welbertdeoliveira/Protecao-contra-descargas-atmosfericas/DIAGRAMAS - IMAGENS E FOTOS/2013-05-27_16-30-04_356 (1).jpg

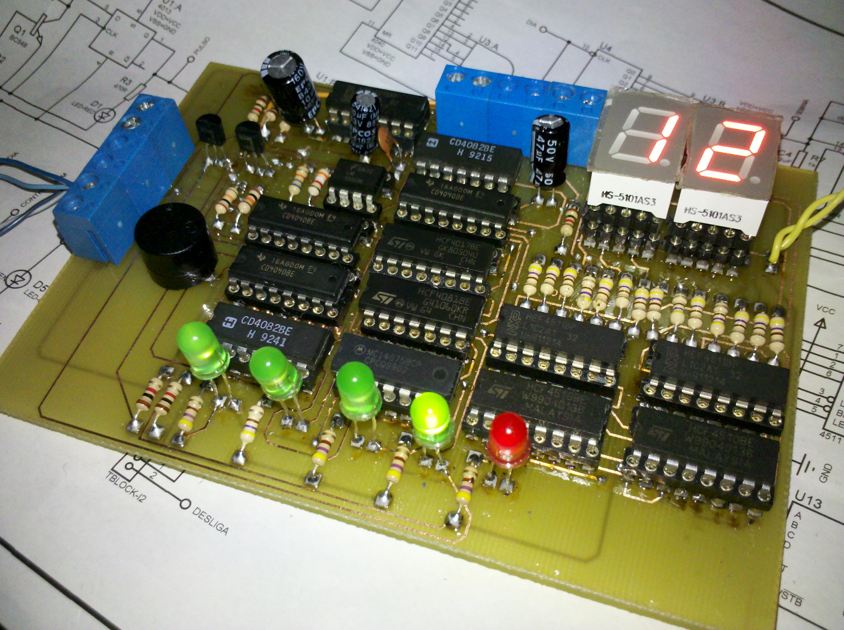
DIAGRAMAS - IMAGENS E FOTOS/2013-05-27_16-30-04_356 (1).jpg
