welbertdeoliveira/Protecao-contra-descargas-atmosfericas/BANNER/BANNER.pdf

# PROTEÇÃO ELETRÔNICA CONTRA SURTOS NA REDE ELÉTRICA

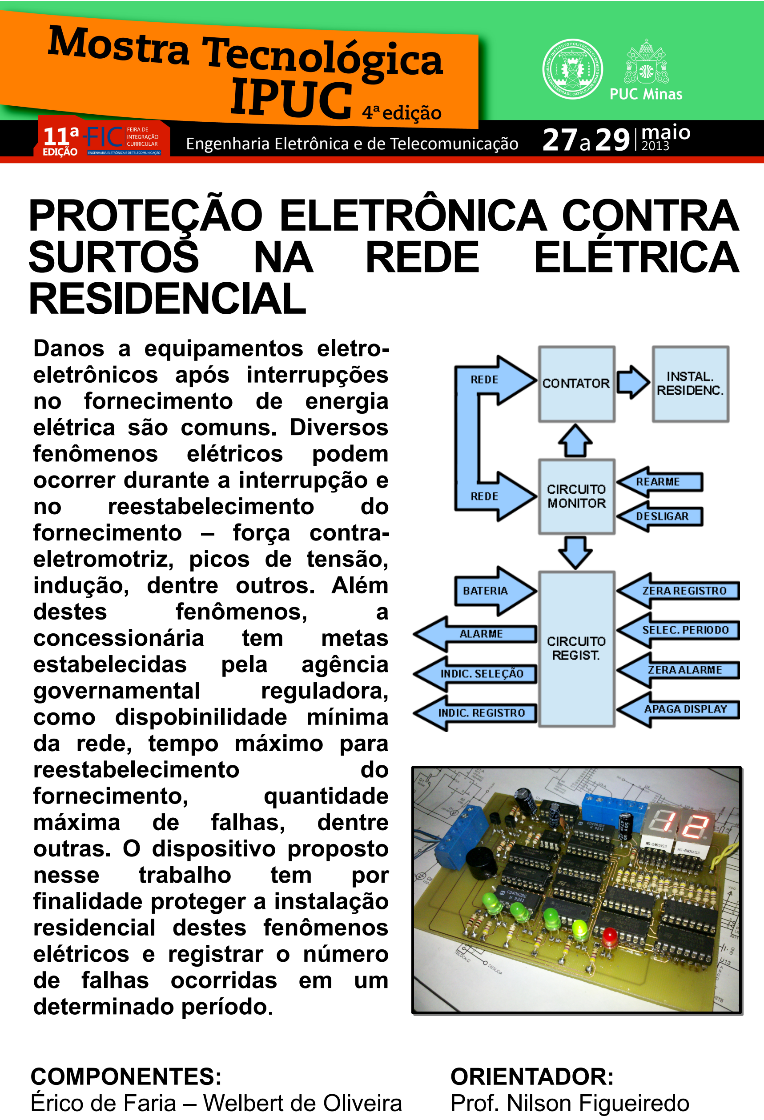
[picture p6: page 1]

Danos a equipamentos eletroeletrônicos após interrupções no fornecimento de energia elétrica são comuns. Diversos fenômenos elétricos podem
ocorrer durante a interrupção e
no | reestabelecimento | do
fornecimento – força contraeletromotriz, picos de tensão, indução, dentre outros. Além
destes | fenômenos, | a
concessionária | tem | metas
estabelecidas | pela | agência
governamental | reguladora,
como dispobinilidade mínima da rede, tempo máximo para
reestabelecimento | do
fornecimento, | quantidade
máxima de falhas, dentre
outras. O dispositivo proposto
nesse | trabalho | tem | por
finalidade proteger a instalação residencial destes fenômenos elétricos e registrar o número de falhas ocorridas em um
determinado período.

# RESIDENCIAL

COMPONENTES:
Érico de Faria – Welbert de Oliveira

ORIENTADOR:
Prof. Nilson Figueiredo

Engenharia Eletrônica e de Telecomunicação
