welbertdeoliveira/Protecao-contra-descargas-atmosfericas/DIAGRAMAS - IMAGENS E FOTOS/CIRCUITO MONITOR.BMP

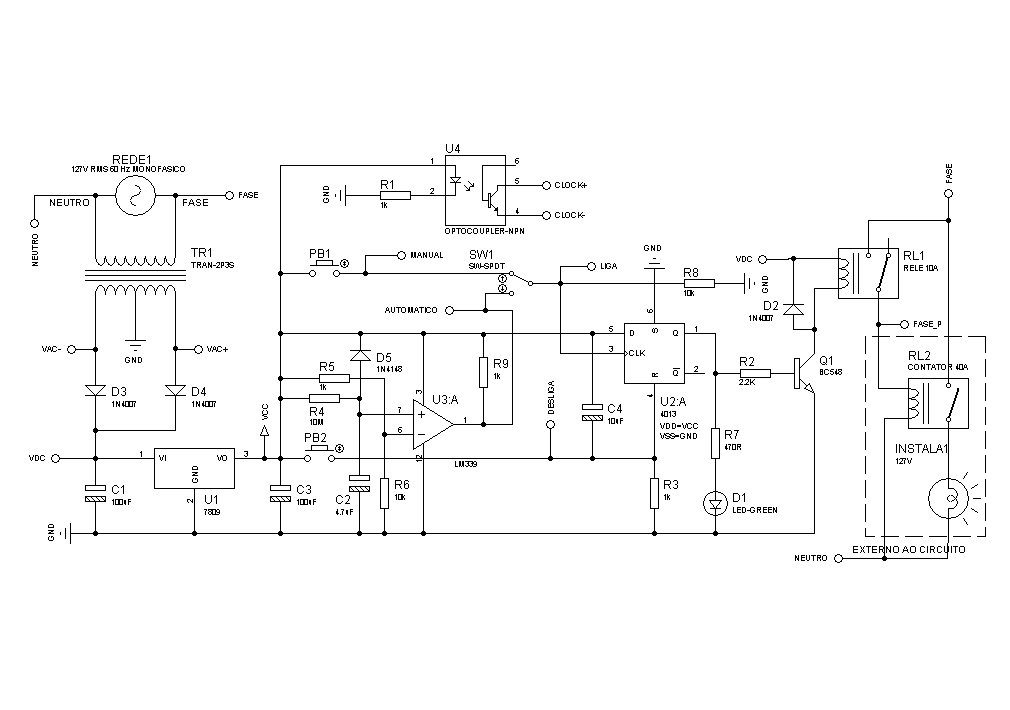
DIAGRAMAS - IMAGENS E FOTOS/CIRCUITO MONITOR.BMP
