welbertdeoliveira/Protecao-contra-descargas-atmosfericas/DIAGRAMAS - IMAGENS E FOTOS/circuito registrador - parte 2.bmp

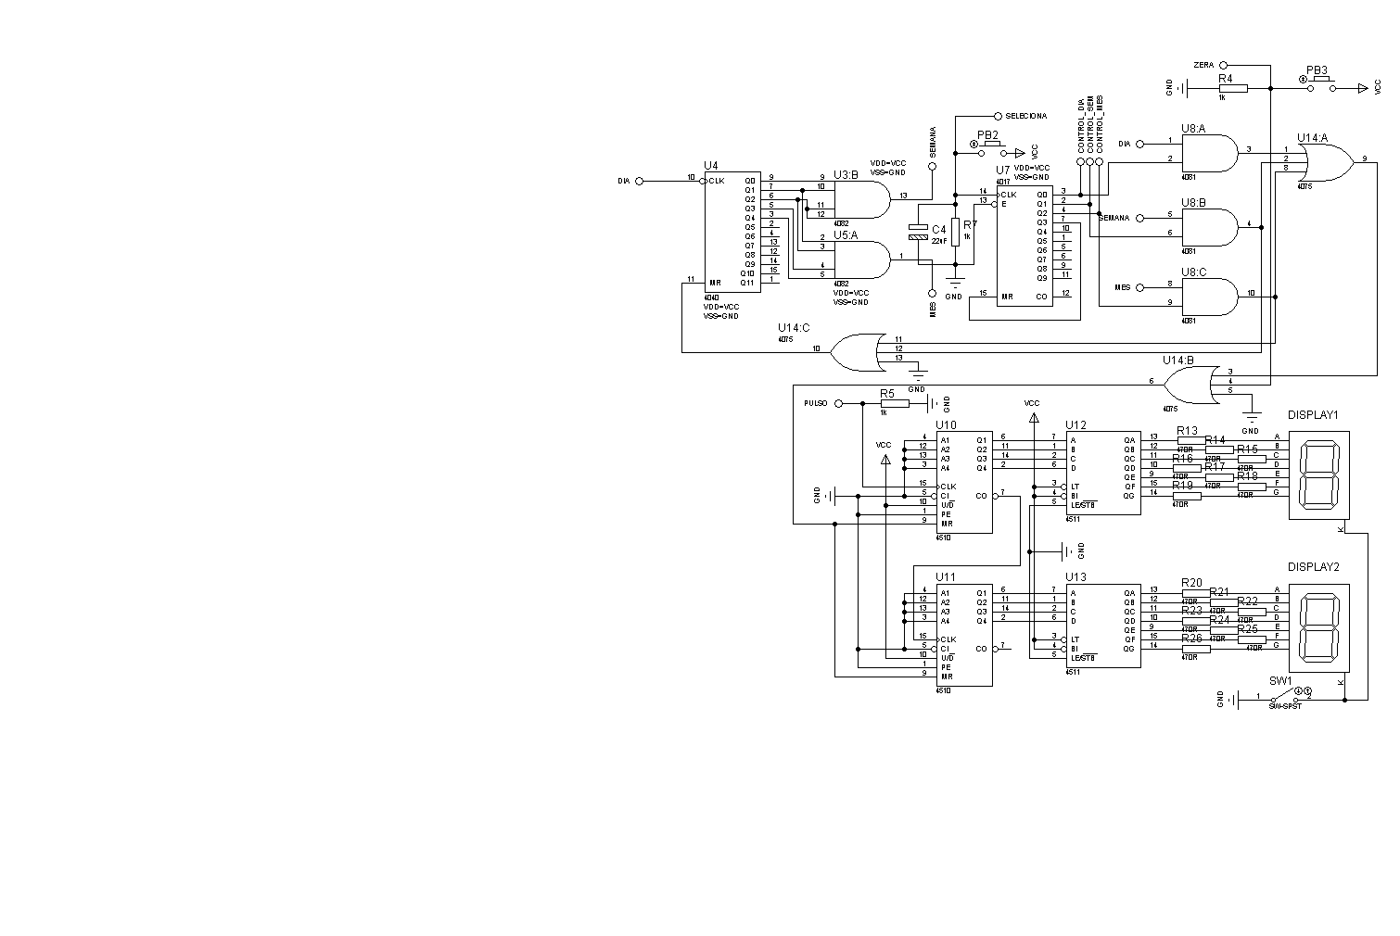
DIAGRAMAS - IMAGENS E FOTOS/circuito registrador - parte 2.bmp
