welbertdeoliveira/Protecao-contra-descargas-atmosfericas/DIAGRAMAS - IMAGENS E FOTOS/CIRCUITO REGISTRADOR.BMP

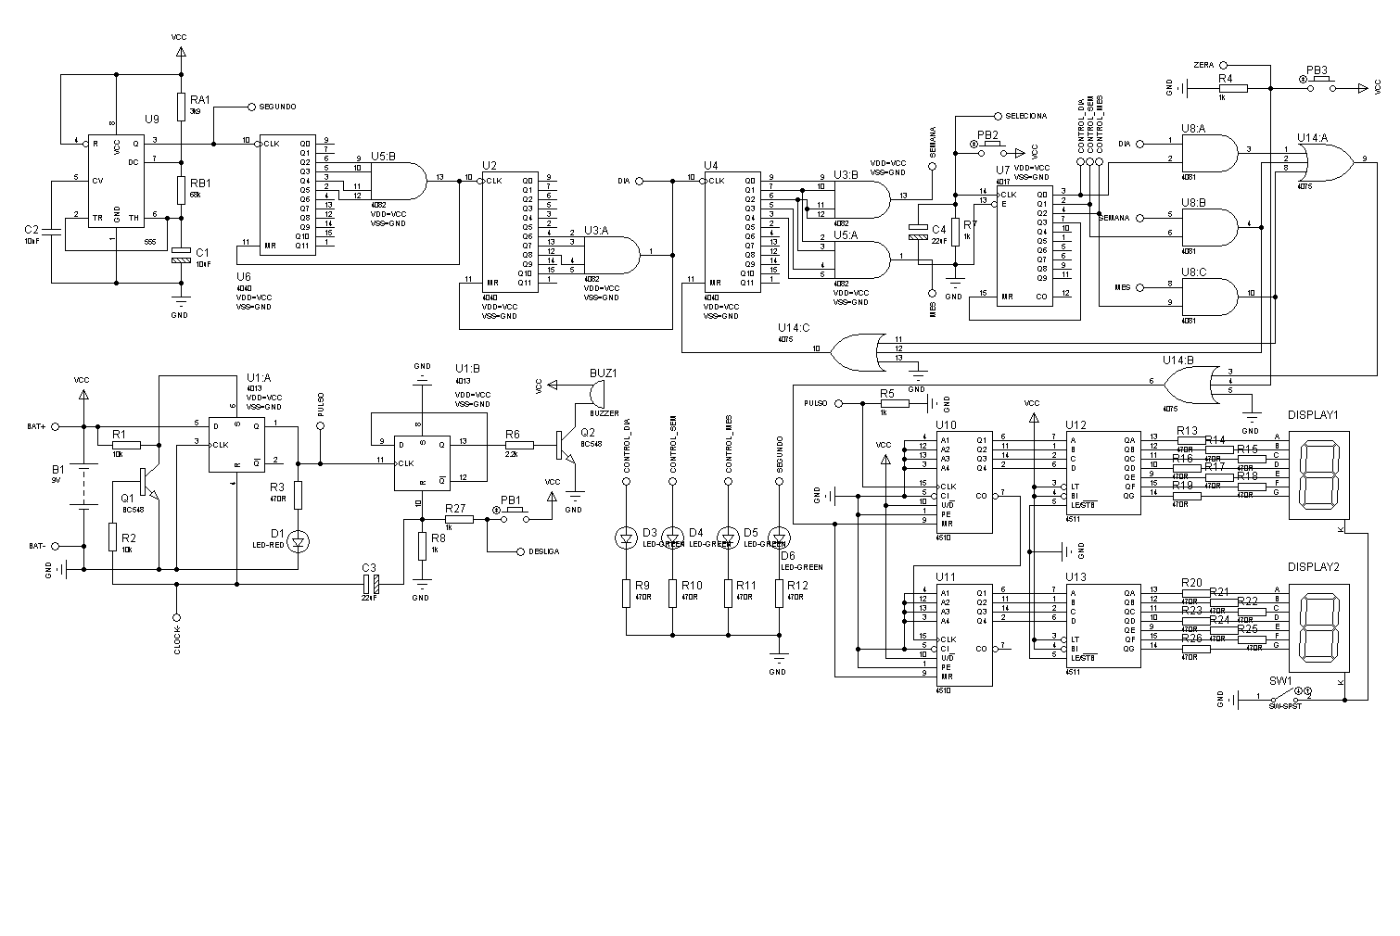
DIAGRAMAS - IMAGENS E FOTOS/CIRCUITO REGISTRADOR.BMP
