welbertdeoliveira/Protecao-contra-descargas-atmosfericas/DIAGRAMAS - IMAGENS E FOTOS/registrador_bmp.bmp

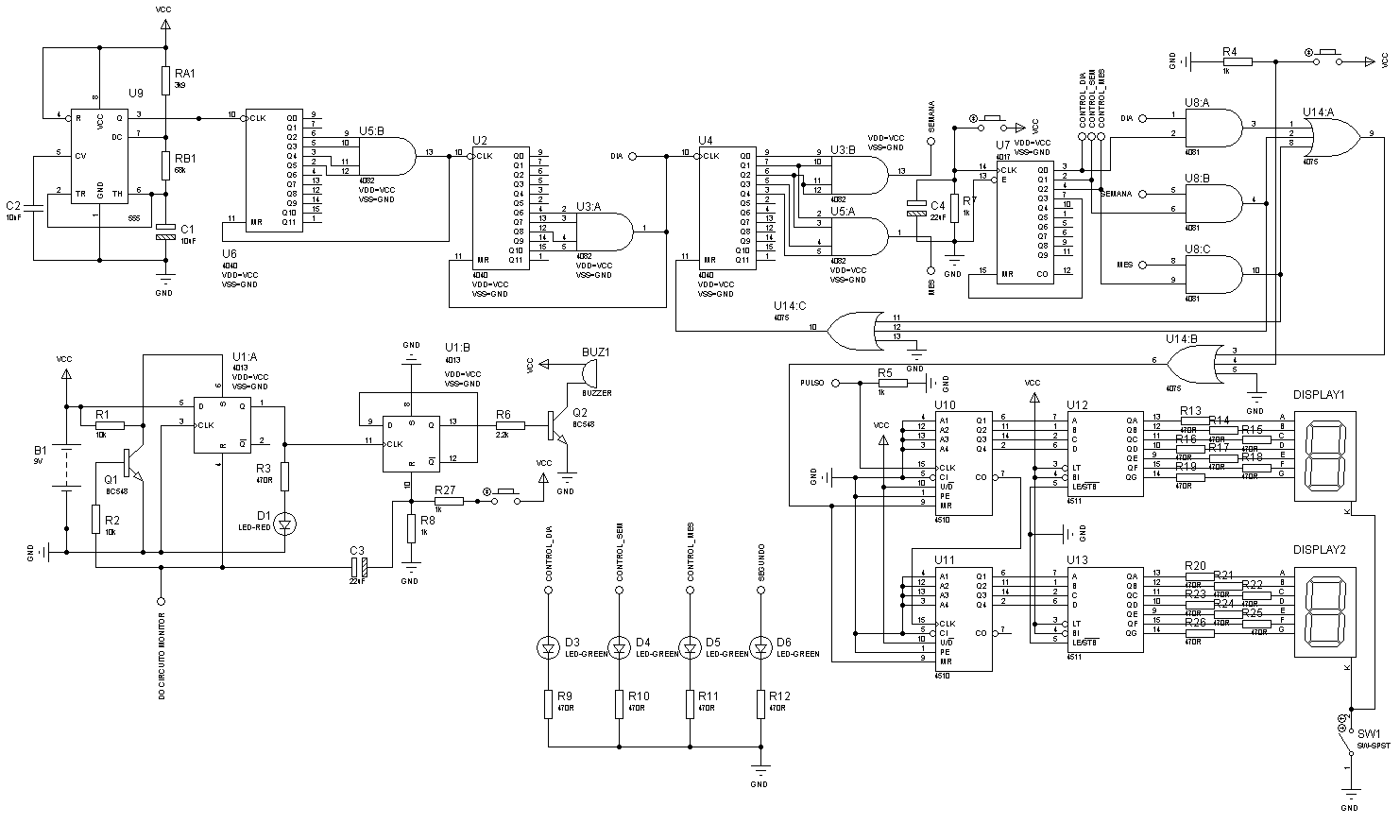
DIAGRAMAS - IMAGENS E FOTOS/registrador_bmp.bmp
