welbertdeoliveira/Protecao-contra-descargas-atmosfericas/DIAGRAMAS - IMAGENS E FOTOS/PROJETO 2.pdf

J1

J2

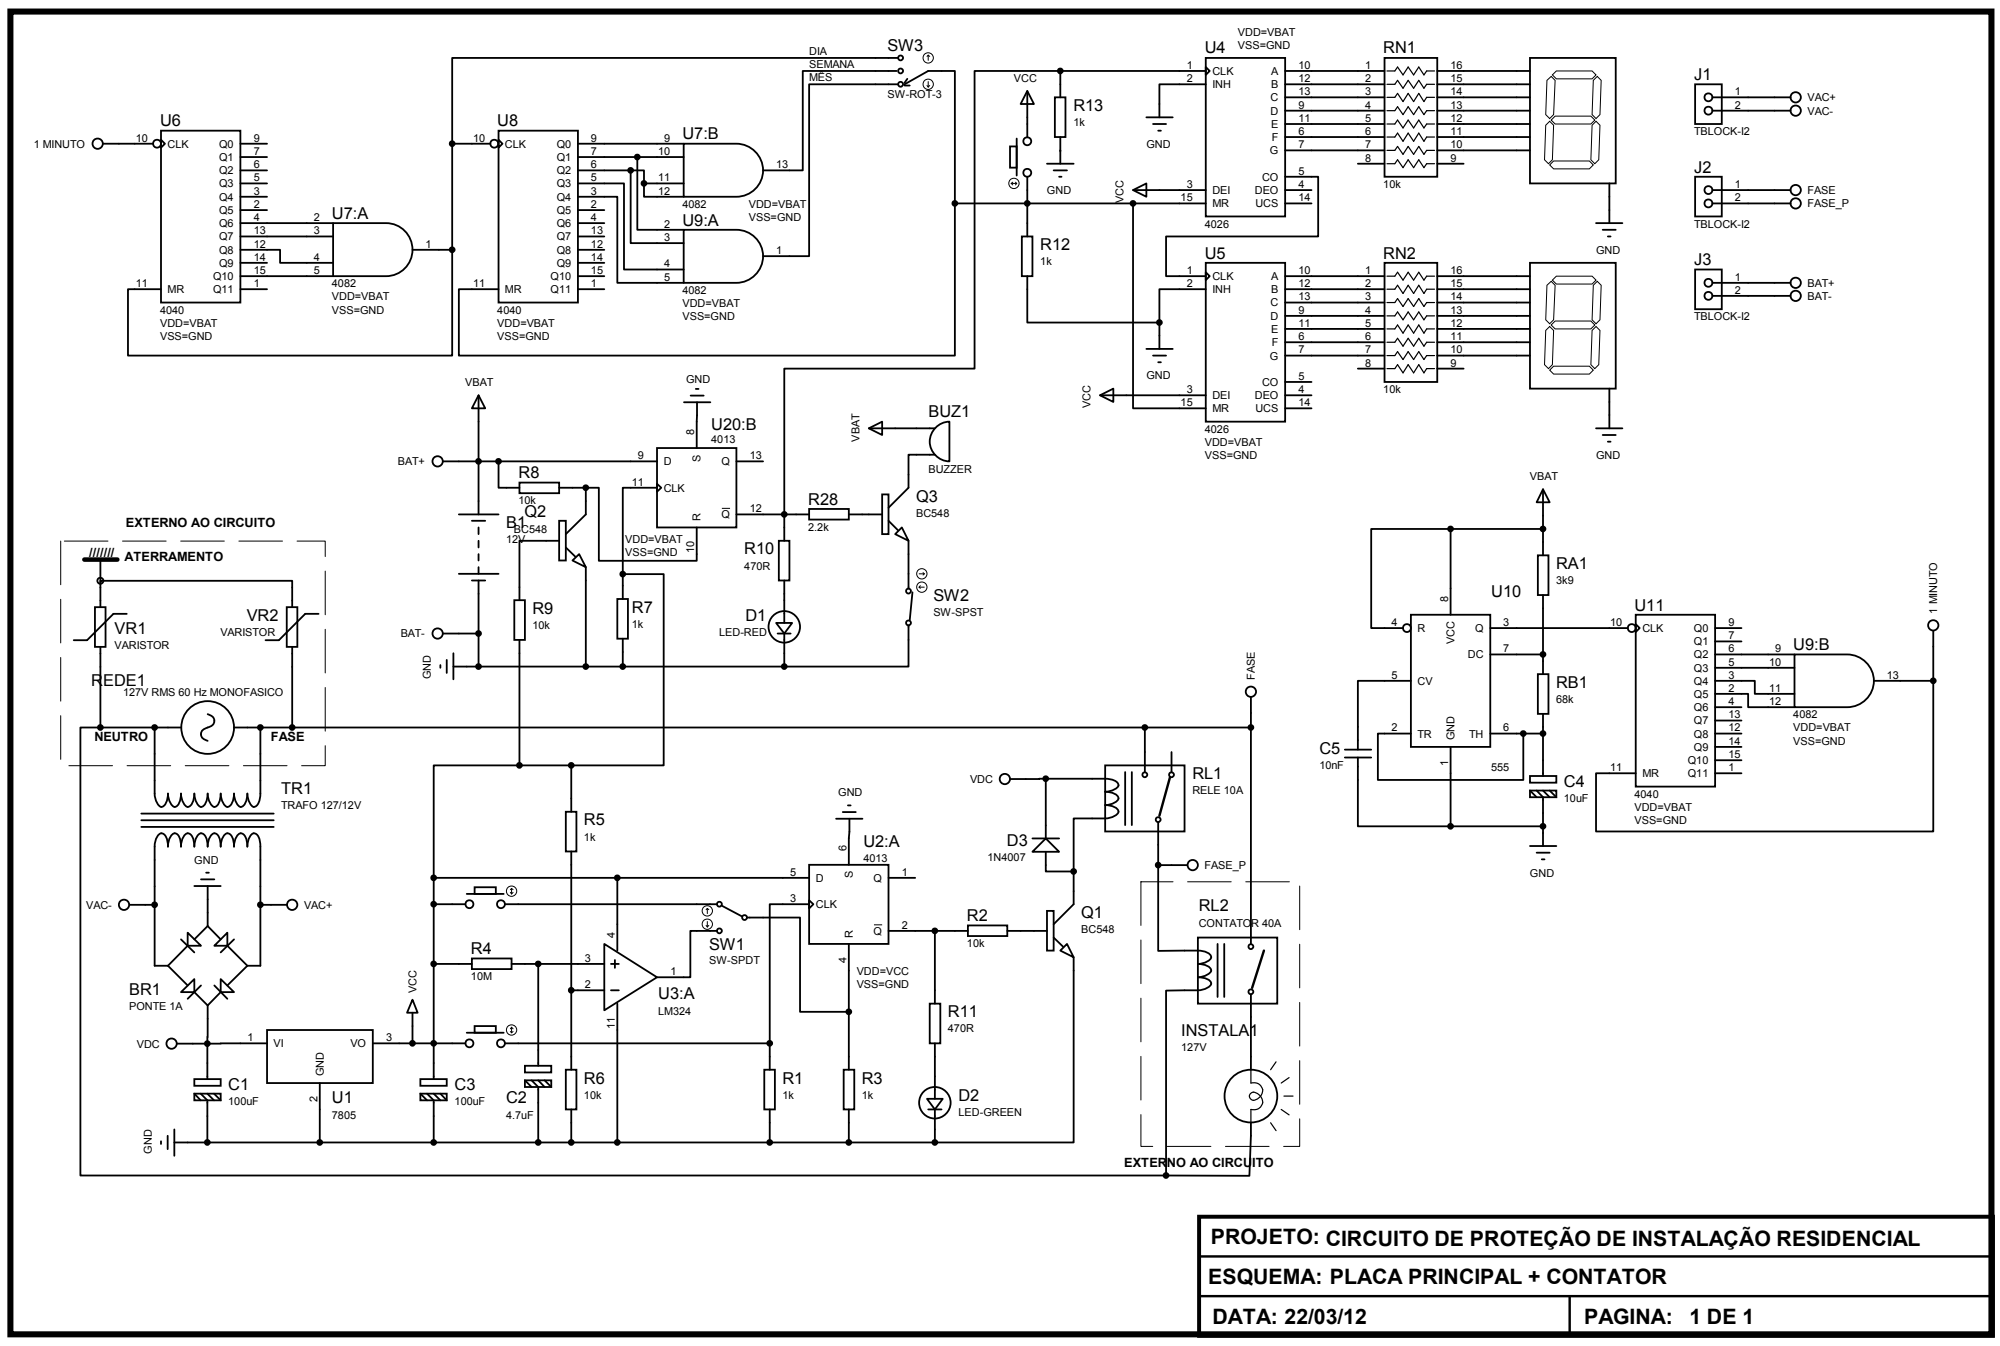
[picture p11: page 1]

CIRCUITO DE PROTEÇÃO DE INSTALAÇÃO RESIDENCIAL
