welbertdeoliveira/Protecao-contra-descargas-atmosfericas/DIAGRAMAS - IMAGENS E FOTOS/PROJETO.pdf

B1
Q2

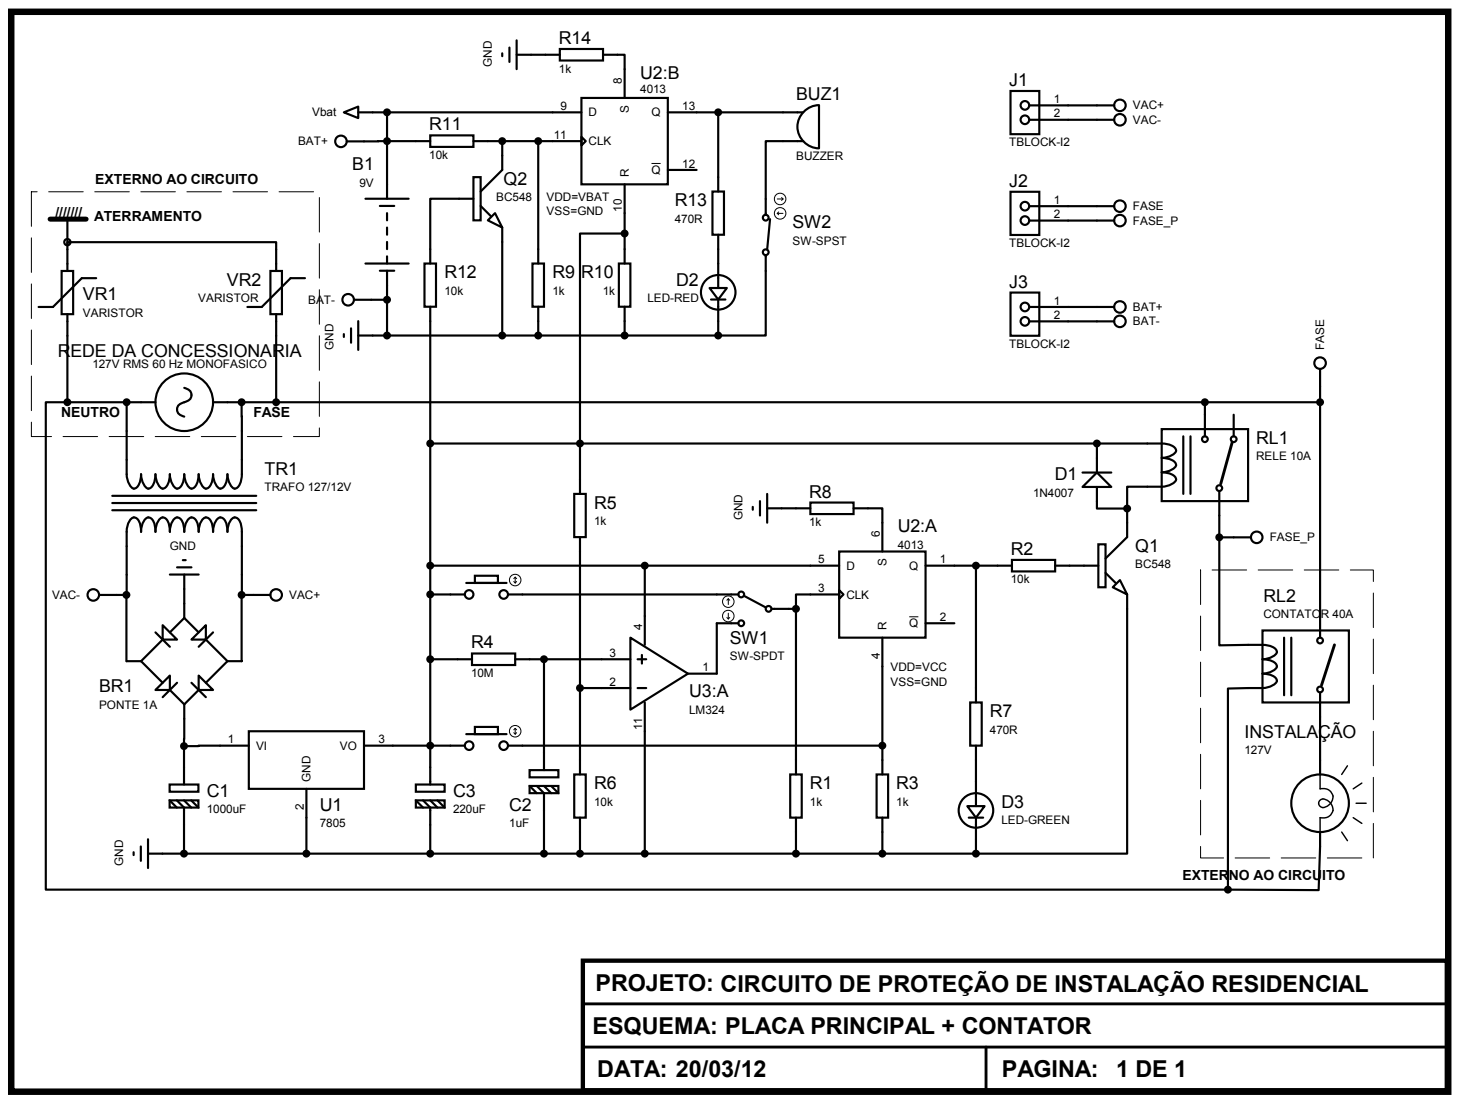
[picture p12: page 1]

CIRCUITO DE PROTEÇÃO DE INSTALAÇÃO RESIDENCIAL
