welbertdeoliveira/Protecao-contra-descargas-atmosfericas/(list of files, drawings)

Other design files:
DIAGRAMAS - PROTEUS/CIRCUITO DEBOUNCING.DSN
DIAGRAMAS - PROTEUS/CIRCUITO MONITOR.DSN
DIAGRAMAS - PROTEUS/CIRCUITO MONITOR.LYT
DIAGRAMAS - PROTEUS/CIRCUITO REGISTRADOR.DSN
DIAGRAMAS - PROTEUS/CIRCUITO REGISTRADOR.LYT
DIAGRAMAS - PROTEUS/PROJETO.DSN
PLACAS/CIRCUITO MONITOR.LYT
PLACAS/CIRCUITO REGISTRADOR.LYT
